StanGoditiabois/linefollower/readme.md

# LineFollower

lege repository die je als template kan gebruiken om een eigen repository te starten voor uw linefollower project

A description of my image


## specifications

microcontroller: esp32 wroom 38 pin

motors: n20 1:50/n20 1:30

h-bridge: drv8833

sensors: qtr-8a

batteries: 18650 

wireless communication: ingebouwt in microcontroller

distance sensor - motors: 98 mm

weight:

speed: 0.68 m/s
