StanGoditiabois/linefollower/code/proof of concepts/wireless communication/readme.md

# draadloze communicatie proof of concept
minimale hard- en software waarmee aangetoond wordt dat duplex kan gecommuniceerd worden tussen de microcontroller en een android smartphone, gebruik makend van "serial bluetooth monitor".
<br />
### configuratie
Verander binnen de code de bluetooth naam van je apparaat. voor de rest moet er niks worden aangepast.

### gebruiksaanwijzing
sluit de esp32 aan op je computer (bedraad) en verbind via bluetooth met je gsm. open de app en verbind nu via de app met de esp32, nu kan je via de app een boodschap versturen deze zou op de computer zichtbaar moeten zijn, omgekeerd werkt ook.
