StanGoditiabois/linefollower/code/proof of concepts/hbridge/image.png

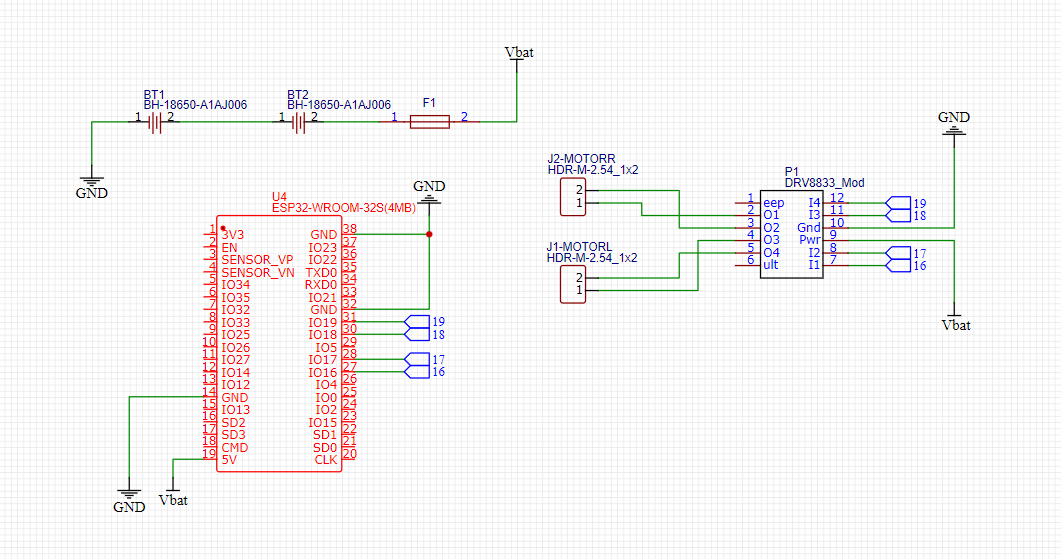
code/proof of concepts/hbridge/image.png
