StanGoditiabois/linefollower/code/proof of concepts/interrupt/image.png

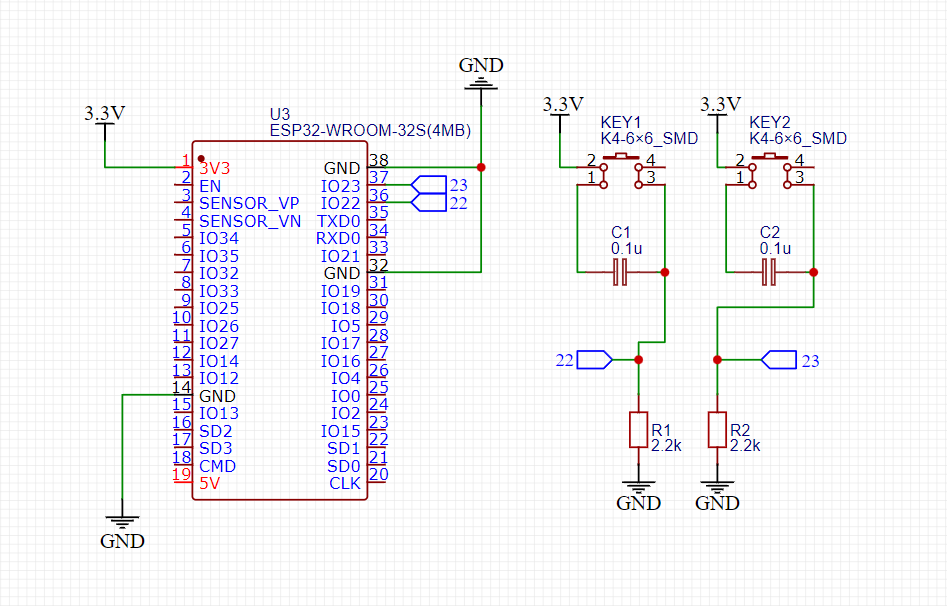
code/proof of concepts/interrupt/image.png
