StanGoditiabois/linefollower/code/proof of concepts/sensor/image.png

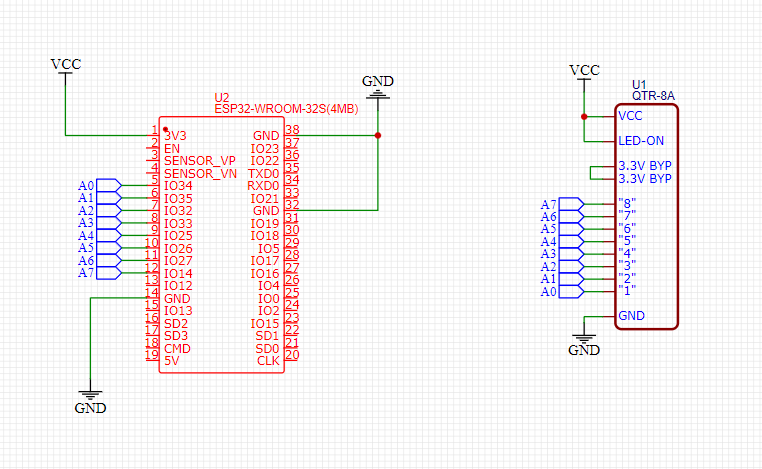
code/proof of concepts/sensor/image.png
