StanGoditiabois/linefollower/datasheets/drv8833 breakout.png

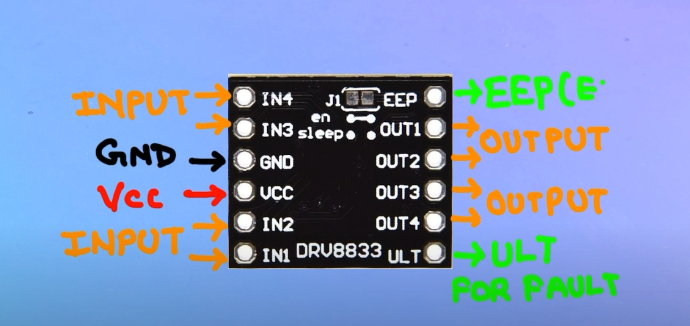
datasheets/drv8833 breakout.png
