StanGoditiabois/linefollower/datasheets/QRE1113.png

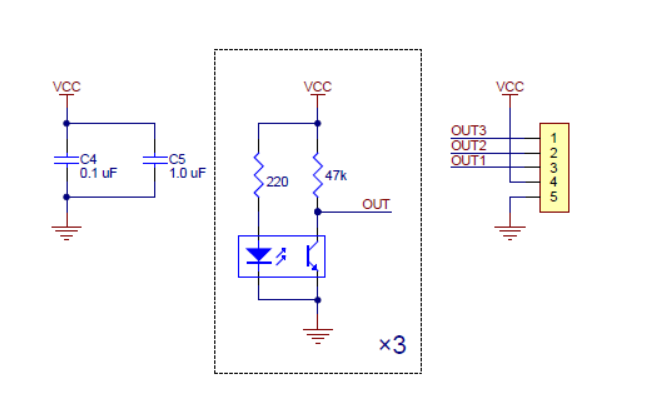
datasheets/QRE1113.png
