StanGoditiabois/linefollower/technische tekeningen/elektronisch/image.png

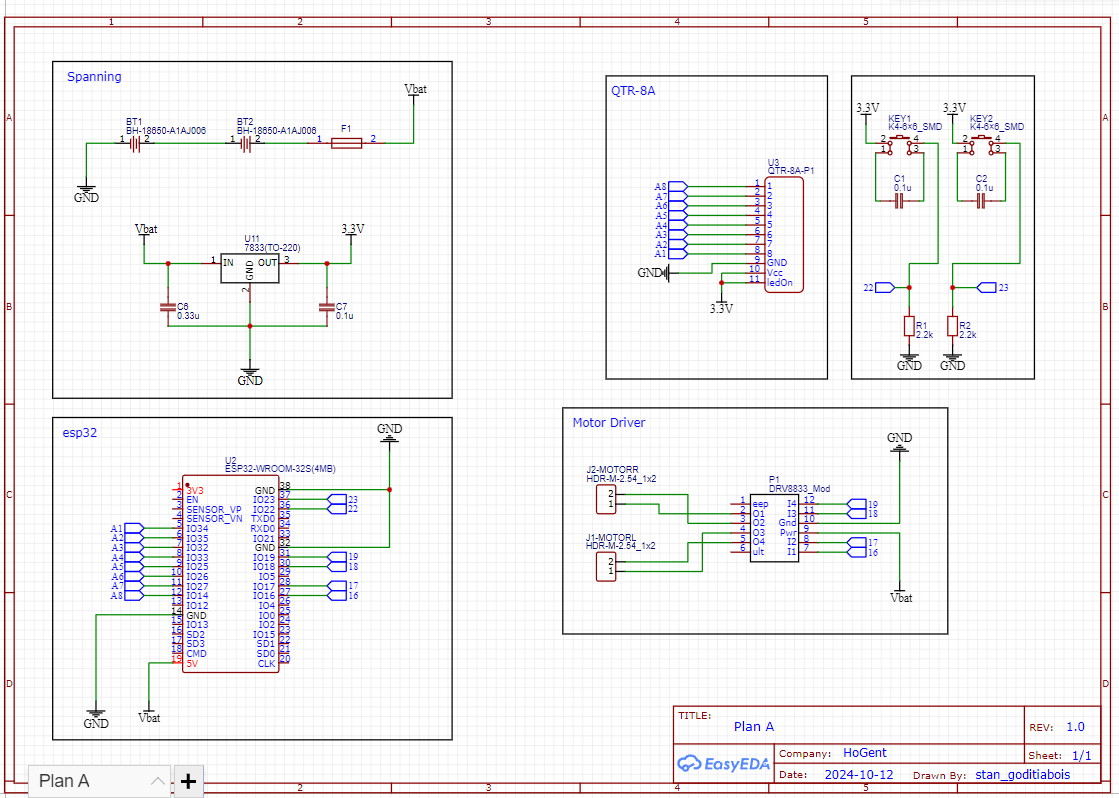
technische tekeningen/elektronisch/image.png
