StanGoditiabois/linefollower/bill of materials/readme.md

## bill of materials
<br />

|volgnummer|naam|omschrijving|nieuw/recup|kostprijs/stuk (euro)|aantal|subtotaal (euro)|
|---|----|---|---|---|---|---|
| 1|PCB auto|5st |nieuw|7.8|1|7.8|
|2|batterijhouder|18650 Batterijhouder voor Printplaat|nieuw|1.24|2|2.48|
|3|DRV8833|Bipolaire Stappenmotor- en DC-Motoraansturing|nieuw|2.48|1|2.48|
|4|zekering|Zelfherstellende zekering PPTC 2000mA|nieuw|1.07|1|1.07|
|5|SMD Weerstanden|1Ω-10MΩ 0805 SMD Weerstanden Set|nieuw|6.61|1|6.61|
|6|SMD condensator|SMD condensator 100nF per 10st 0805|nieuw|1.21|1|1.21|
|7|female header pin|Rechte header - 1x40 pin - P = 2,54|nieuw|1.5|3|4.5|
|8|male header pin|40 Pins header Male 2.54|nieuw|0.33|1|0.33|
|9|QTR-8A|Pololu QTR-8A Reflectiesensor Array|nieuw|11.47|1|11.47|
|10|SMD Tact Switch|SMD Tact Switch Horizontal 4,3mm 1,6N 6,2x6,2mm|nieuw|0.46|2|0.92|
|11|GA12-N20 Tandwielmotor|Dc 3V/6V/12V N20 Mini Micro Metalen Tandwielmotor Met Tandwiel Dc Motoren 1:50|nieuw|3.41|2|6.28|
|12|Wiel Voor N20 Motor|10 Stks/partij D-Hole Rubber Wiel Geschikt Voor N20 Motor D As|nieuw|0.93|1|0.93
|13|ESP32 Development Board|1-10PCS/ESP32 Development Board Type-C CP2102 WIFI Bluetooth Module Dual Core Draadloze Module ESP-WROOM-32 Uitbreidingskaart 38Pin|nieuw|4.82|1|4.82|
|14|dupont draadjes|Dupont Lijn 10/20/30/40Cm 40pin Mannelijk Naar Mannelijk + Mannelijk Naar Vrouwelijk En Vrouwelijk Naar Vrouwelijk Jumper Draad Dupont Kabel Voor Arduino Diy Kit|nieuw|2.03|1|2.03|
|15|bout|bout m3|recup| |4| |
|16|moer|moer m3|recup| |4| |
|17|3D print||school||1||
|18|oogje|verhoog voor onder sensor|recup||1||
|19|Volt regulator|LF33CV Volt regulator|nieuw|0.82|1|0.82|
|20|Balast vooraan||recup||||
