StanGoditiabois/linefollower/technische tekeningen/mechanisch/gearmotor_b1r (2).stl

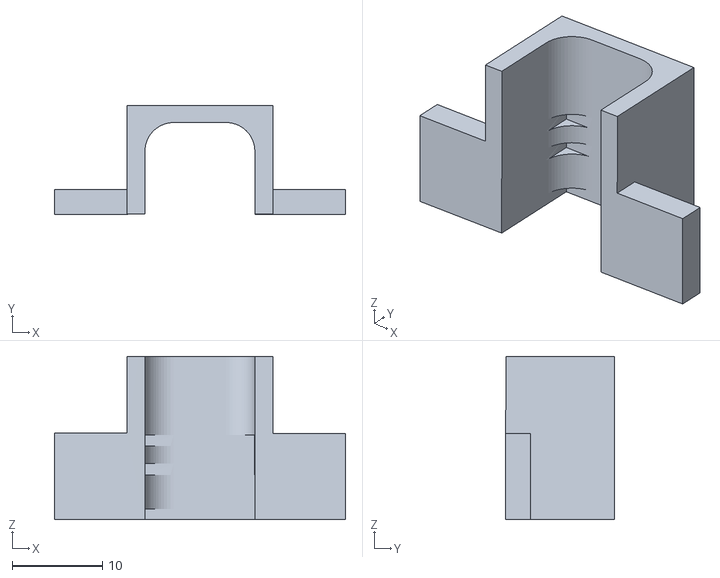
[picture p9: CAD file, 2024-12-13]
technische tekeningen/mechanisch/gearmotor_b1r (2).stl
32.3 x 12.1 x 18.1
