StanGoditiabois/linefollower/(commit log)

2024-12-10 afbeelding POC qtr-8a sensor
2024-12-10 programma voor het testen van de sensoren
2024-12-10 programma voor het testen van de beide knoppen
2024-12-10 afbeelding van de schakeling van 2 knoppen
2024-12-10 programma om de motor driver te testen
2024-12-10 afbeelding schema motor driver
2024-12-10 uploaden tekening pcb
2024-12-13 uploaden bestand voor motorhouder
    [gearmotor_b1r (2).stl]
